ExploreEmbedded/ATmega32_ExploreStarterAvr/Others/Fritzing/Fritzing Tutorial Images/0_RTC_Starter_AVR_fritzing.png

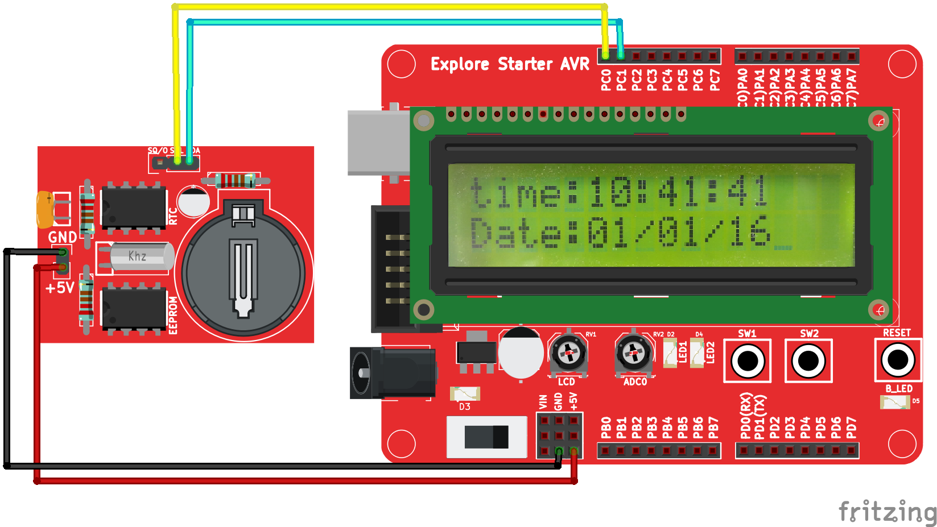
Others/Fritzing/Fritzing Tutorial Images/0_RTC_Starter_AVR_fritzing.png
