ExploreEmbedded/ATmega32_ExploreStarterAvr/Others/BOM/Explore Starter_AVR_BOM.xls

 | Explore Starter AVR |  | No. of PCB's | 25
Id | Designator | Package | Units | Designation | Qty. | Supplier and ref
1 | CON1 | USB B FEMALE SOLDER R/A | 1 | USB B Type | 25 | Namotronics
2 | SW4,SW3,SW1 | 2 pin through hole switch | 3 | 2 pin Tactile switch | 75 | Namotronics
3 | C7 | Electrolyte | 1 | 100uf/25V Capacitors | 25 | Namotronics
4 | K4,K3,K2 | 2.54mm Pitch through hole staright | 0.25 | Male Pin headers | 6.25 | Namotronics
5 | IC1 | DIP -40 | 1 | 40 Pin Low profile IC Socket | 25 | Namotronics
6 | J3,J2,J4,J5 | 2.54mm Pitch through hole staright | 1 | Male Pin headers | 25 | Namotronics
7 | P6 | 2.54mm Pitch through hole staright | 1 | 5X2 FRC Box headers | 25 | Namotronics
8 | RV1,RV2 | 3 pin Preset | 2 | 10K Potentiometer | 50 | Namotronics
10 | U1 | MLP-28 | 1 | CP2102 | 25 | Namotronics
11 | U2 | SOT223 | 1 | LM1117/5V | 25 | Namotronics
12 | X1 | Through hole | 1 | 16Mhz Crystal | 25 | Namotronics
13 | C10,C11,C1,C2,C3,C4,C5 | 1206 Package | 7 | 0.1uF Capacitors | 175 | Namotronics
15 | R1 | 1206 Package | 1 | 10K Resistors | 25 | Namotronics
17 | R3,R5,R6,R2 | 1206 Package | 4 | 470R Resistors | 100 | Namotronics
18 | R7,R8 | 1206 Package | 2 | 10k Resistors | 50 | Namotronics
19 | R9 | 1206 Package | 1 | 2.2k Resistors | 25 | Namotronics
20 | C8,C9 | 1206 Package | 2 | 22pF Capacitors | 50 | Namotronics
21 | D2,D3,D4,D5 | 1206 Package | 4 | Green LED | 100 | Namotronics
22 | K1 | DC Jack | 1 | BARREL_JACK | 25 | Namotronics
23 | LCD1 | 2.54mm Pitch through hole staright | 1 | Female Pin headers | 25 | Namotronics
24 | SW2 | 2.54mm 5 pin slide swith | 1 | R/A slide swith | 25 | Namotronics
