ExploreEmbedded/ATmega32_ExploreStarterAvr/Code/Tutorial Examples/LCD 16x2/LCD 16x2/New Microsoft Office Word Document.docx

#include <avr/io.h>

#include <util/delay.h>

#include "lcd.h"

/********************************************************************

26

27 Configuration Area.

28 UltraSonic (US) sensor connection.

29

30 in this example it is connected to PORTA bit 0

31

32 Adjust the following to connect is to different i/o

33

34 ********************************************************************/

#define US_PORT PORTA

#define US_PIN PINA

#define US_DDR DDRA

#define US_POS PA0 //PORTA0

#define trig PA1

/********************************************************************

44

45 This function measusers the width of high pulse in micro second.

46

47 ********************************************************************/

#define US_ERROR 0xffff

#define US_NO_OBSTACLE 0xfffe

uint16_t getPulseWidth()

{

uint32_t i,result;

//Wait for the rising edge

for(i=0;i<600000;i++)

{

if(!(US_PIN & (1<<US_POS))) continue; else break;

}

if(i==600000)

return 0xffff; //Indicates time out

//High Edge Found

//Setup Timer1

TCCR1A=0X00;

TCCR1B=(1<<CS11); //Prescaler = Fcpu/8

TCNT1=0x00; //Init counter

//Now wait for the falling edge

for(i=0;i<600000;i++)

{

if(US_PIN & (1<<US_POS))

{

if(TCNT1 > 60000) break; else continue;

}

else

break;

}

if(i==600000)

return 0xffff; //Indicates time out

//Falling edge found

result=TCNT1;

//Stop Timer

TCCR1B=0x00;

if(result > 60000)

return 0xfffe; //No obstacle

else

return (result>>1);

}

void Wait()

{

uint8_t i;

for(i=0;i<10;i++)

_delay_loop_2(0);

}

void main()

{

uint16_t r;

LCD_SetUp(PB_0,PB_1,PB_2,P_NC,P_NC,P_NC,P_NC,PC_4,PC_5,PC_6,PC_7);

LCD_Init(2,16);

LCD_DisplayString("Explore Embedded");

LCD_DisplayString("Lcd 4-bit Mode");

Wait();

while(1)

{

//Set Ultra Sonic Port as out

US_DDR|=(1<<trig);

_delay_us(10);

//Give the US pin a 15us High Pulse

US_PORT|=(1<<trig); //High

_delay_us(15);

US_PORT&=(~(1<<trig));//Low

_delay_us(20);

//Now make the pin input

US_DDR&=(~(1<<US_POS));

//Measure the width of pulse

r=getPulseWidth();

//Handle Errors

if(r==US_ERROR)

{

LCD_DisplayString("Error !");

}

else if(r==US_NO_OBSTACLE)

{

LCD_DisplayString("Clear !");

}

else

{

int d;

d = (r/58.0); //Convert to cm

LCD_Printf("%d",d);

// LCDWriteIntXY(0,0,d,4);

// LCDWriteString(" cm");

Wait();

}

}

}
