ExploreEmbedded/ATmega32_ExploreStarterAvr/Code/Tutorial Examples/Stepper/Stepper/code.docx

/*

* Stepper.c

*

* Created: 11-04-2016 13:04:41

* Author : Vaibhav

*/

#include <avr/io.h>

#include "delay.h"

#include "adc.h"

#define stepPin PB3

#define dirPin PB4

#define Enable PB5

int speedUp();

int customDelay,customDelayMapped;

int main(void)

{

ADC_Init();

/* Replace with your application code */

DDRB |= (1<<3)|(1<<4)|(1<<5);

PORTB |= (1<<4);

PORTB &= ~(1<<5);

int x;

while (1)

{

//volt = (adcValue*5.00)/1023;

customDelayMapped = speedUp();

// for(x=0; x<200; x++)

// {

PORTB |=(1<<3);

DELAY_us(customDelayMapped);

PORTB &=~(1<<3);

DELAY_us(customDelayMapped);

// }

//DELAY_ms(1000);

// PORTB &= ~(1<<4);

//for(x=0; x<400; x++)

//{

// PORTB |=(1<<3);

// DELAY_us(4000);

// PORTB &=~(1<<3);

// DELAY_us(4000);

//}

// DELAY_ms(1000);

}

}

// Function for reading the Potentiometer

int speedUp() {

int customDelay = ADC_GetAdcValue(0); // Reads the potentiometer

// int newCustom = map(customDelay, 0, 1023, 300,4000); // Convrests the read values of the potentiometer from 0 to 1023 into desireded delay values (300 to 4000)

return customDelay;

}
