ExploreEmbedded/ATmega32_ExploreStarterAvr/Others/Fritzing/Fritzing Tutorial Images/0_Stepper_Starter_AVR.png

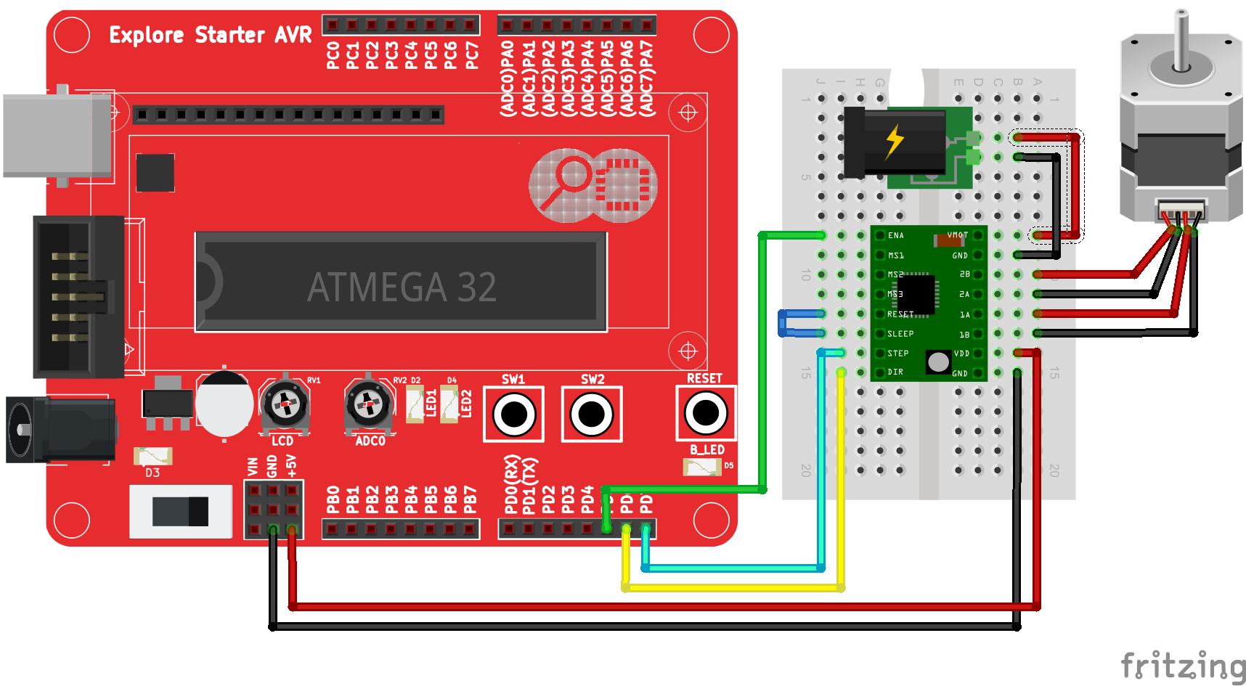
Others/Fritzing/Fritzing Tutorial Images/0_Stepper_Starter_AVR.png
