ExploreEmbedded/ATmega32_ExploreStarterAvr/Others/Fritzing/Fritzing Tutorial Images/7Segment_Starter_AVR1.png

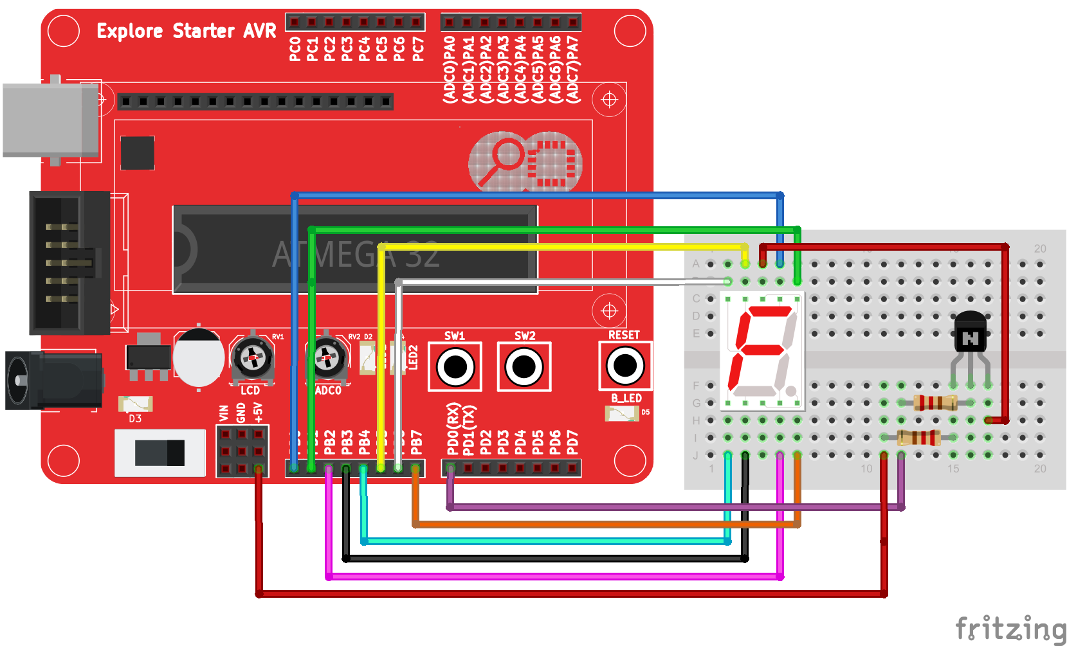
Others/Fritzing/Fritzing Tutorial Images/7Segment_Starter_AVR1.png
