ExploreEmbedded/ATmega32_ExploreStarterAvr/Others/Fritzing/Fritzing Tutorial Images/GLCD_Starter_AVR.png

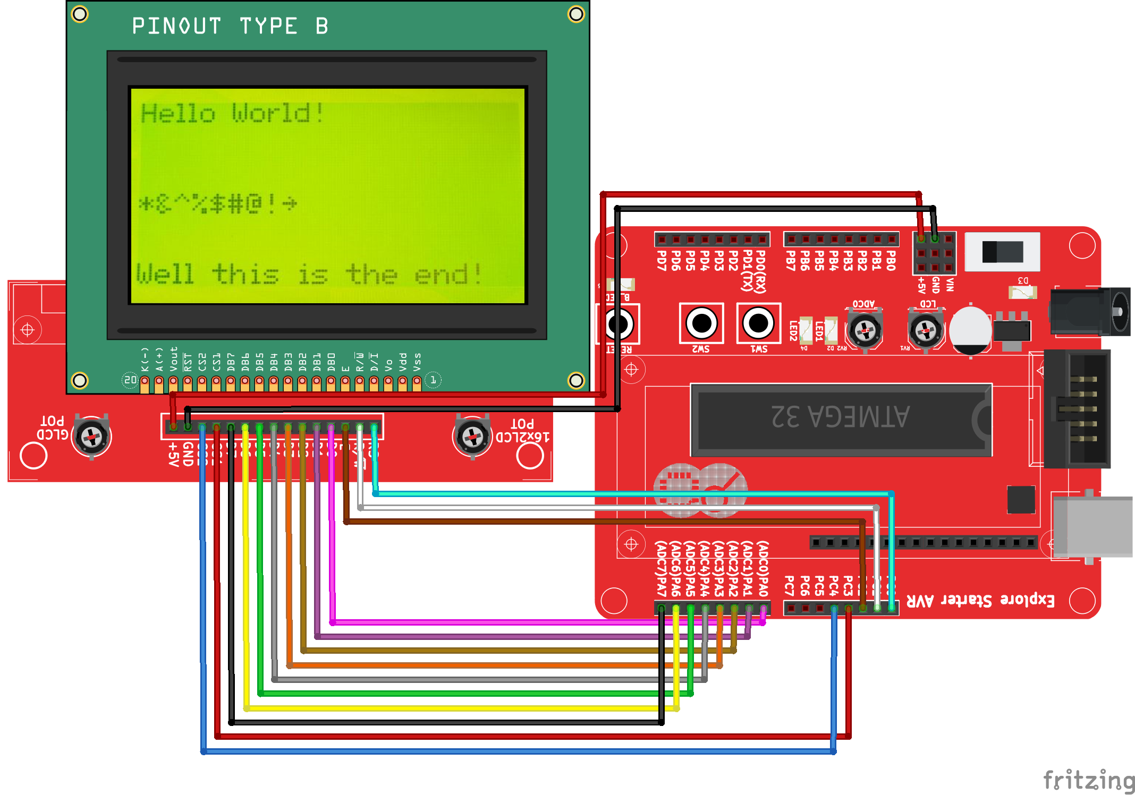
Others/Fritzing/Fritzing Tutorial Images/GLCD_Starter_AVR.png
