ExploreEmbedded/ATmega32_ExploreStarterAvr/Hardware/Starter_AVR.pdf

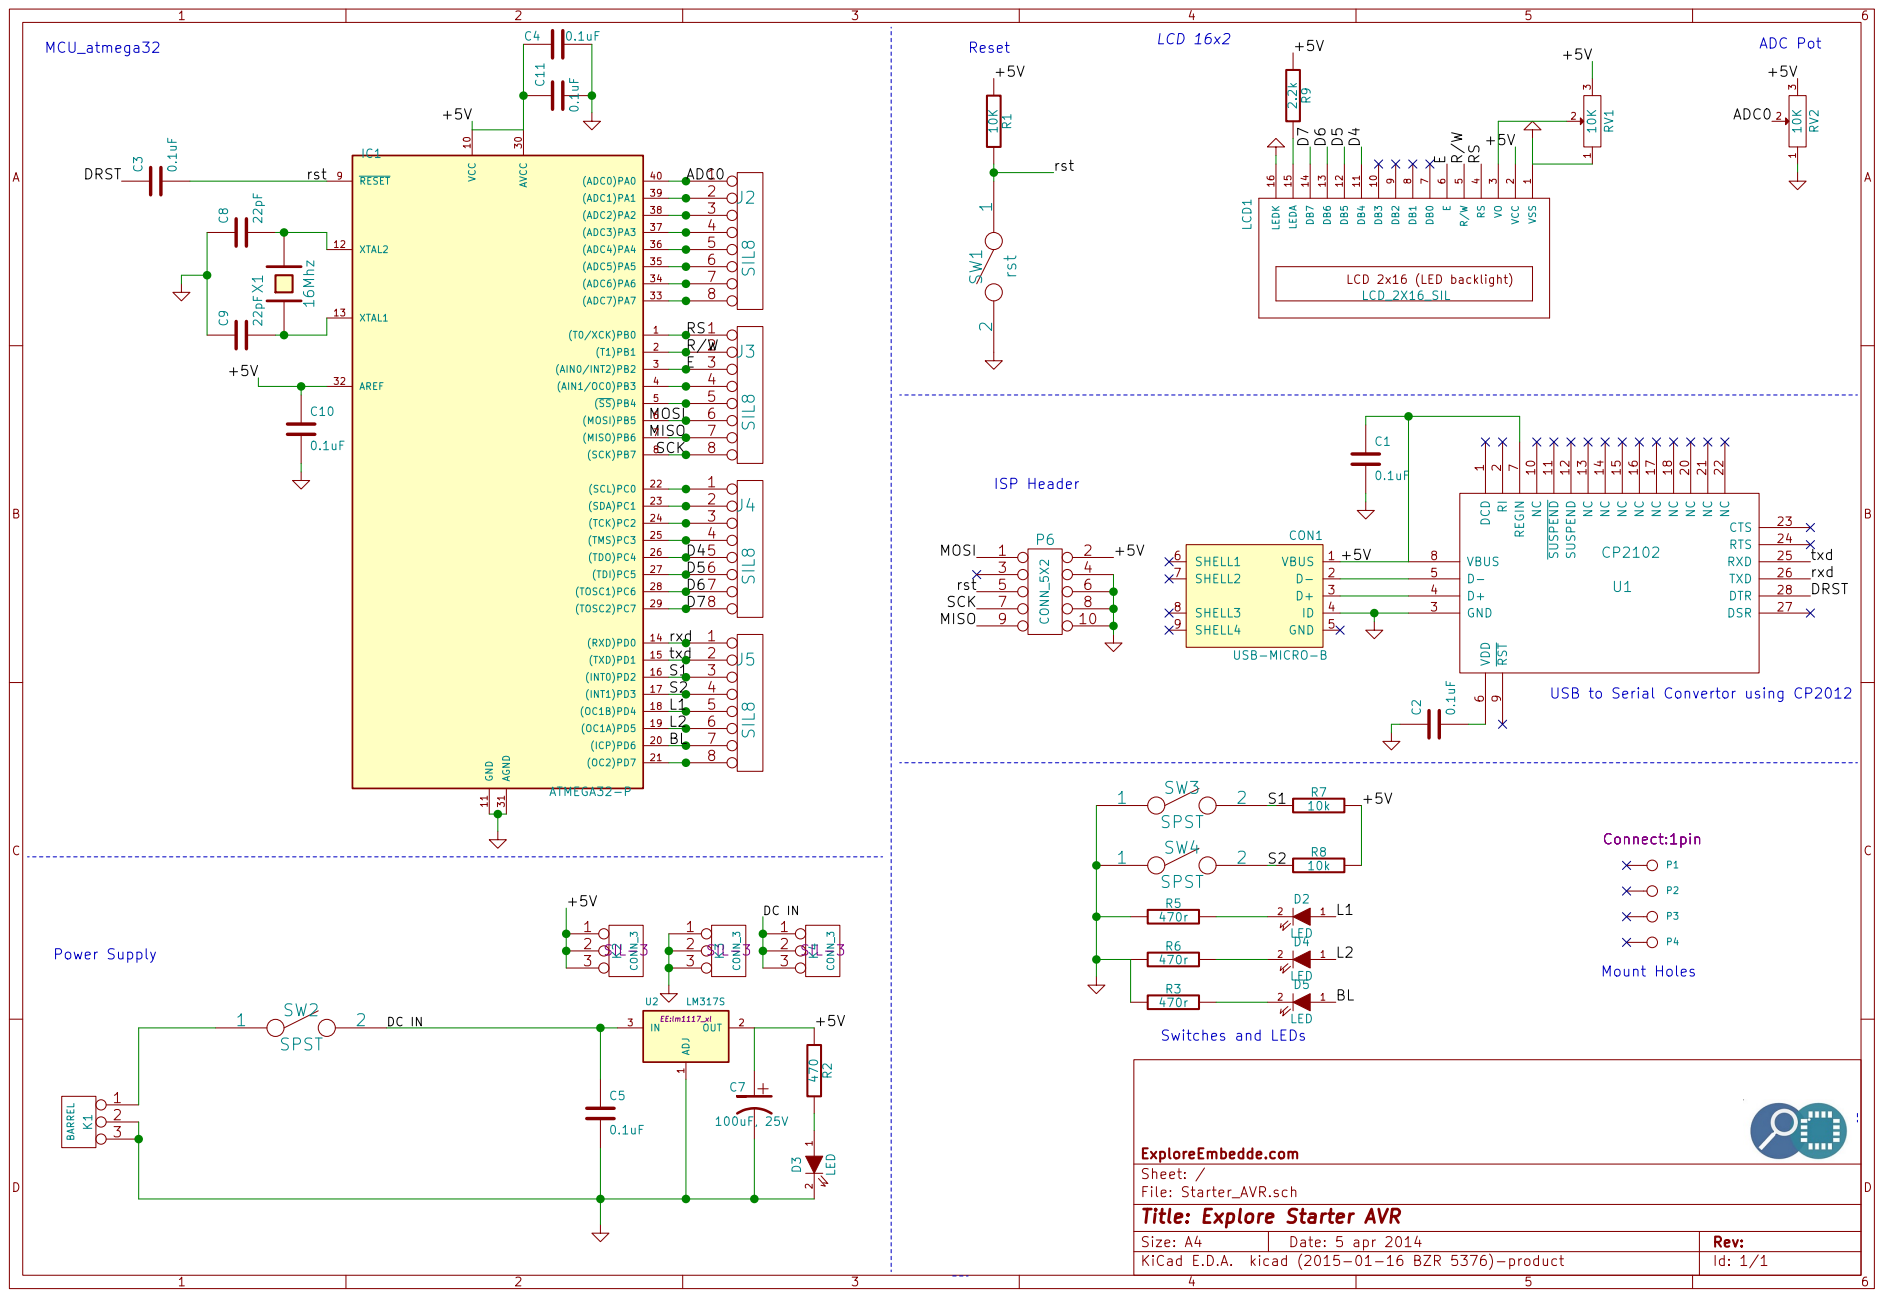
[picture p7: page 1]

9 NC 10 NC 20 SUSPEND 11 NC 21 SUSPEND 12 NC 22 NC 13 CTS 23 NC 14 RTS 24 NC 15 RXD 25 NC 16 TXD 26 NC 17 DSR 27 NC 18 DTR U1 28 CP2102 C1

File: Starter_AVR.sch Sheet: / ExploreEmbedde.com

Id: 1/1 Title: Explore Starter AVR
