ExploreEmbedded/ATmega32_ExploreStarterAvr/(list of files, drawings)

Other design files:
Others/Fritzing/Fritzing Tutorial Images/7segment.fzz
Others/Fritzing/Fritzing Tutorial Images/GLCD.fzz
Others/Fritzing/Fritzing Tutorial Images/LM35.fzz
Others/Fritzing/Fritzing Tutorial Images/RTC.fzz
Others/Fritzing/Fritzing Tutorial Images/Stepper.fzz
Others/Fritzing/Fritzing Tutorial Images/Ultrasonic.fzz
