ExploreEmbedded/ATmega32_ExploreStarterAvr/Hardware/Starter_AVR.kicad_pcb

## KiCad design Hardware/Starter_AVR.kicad_pcb (2016-03-23)

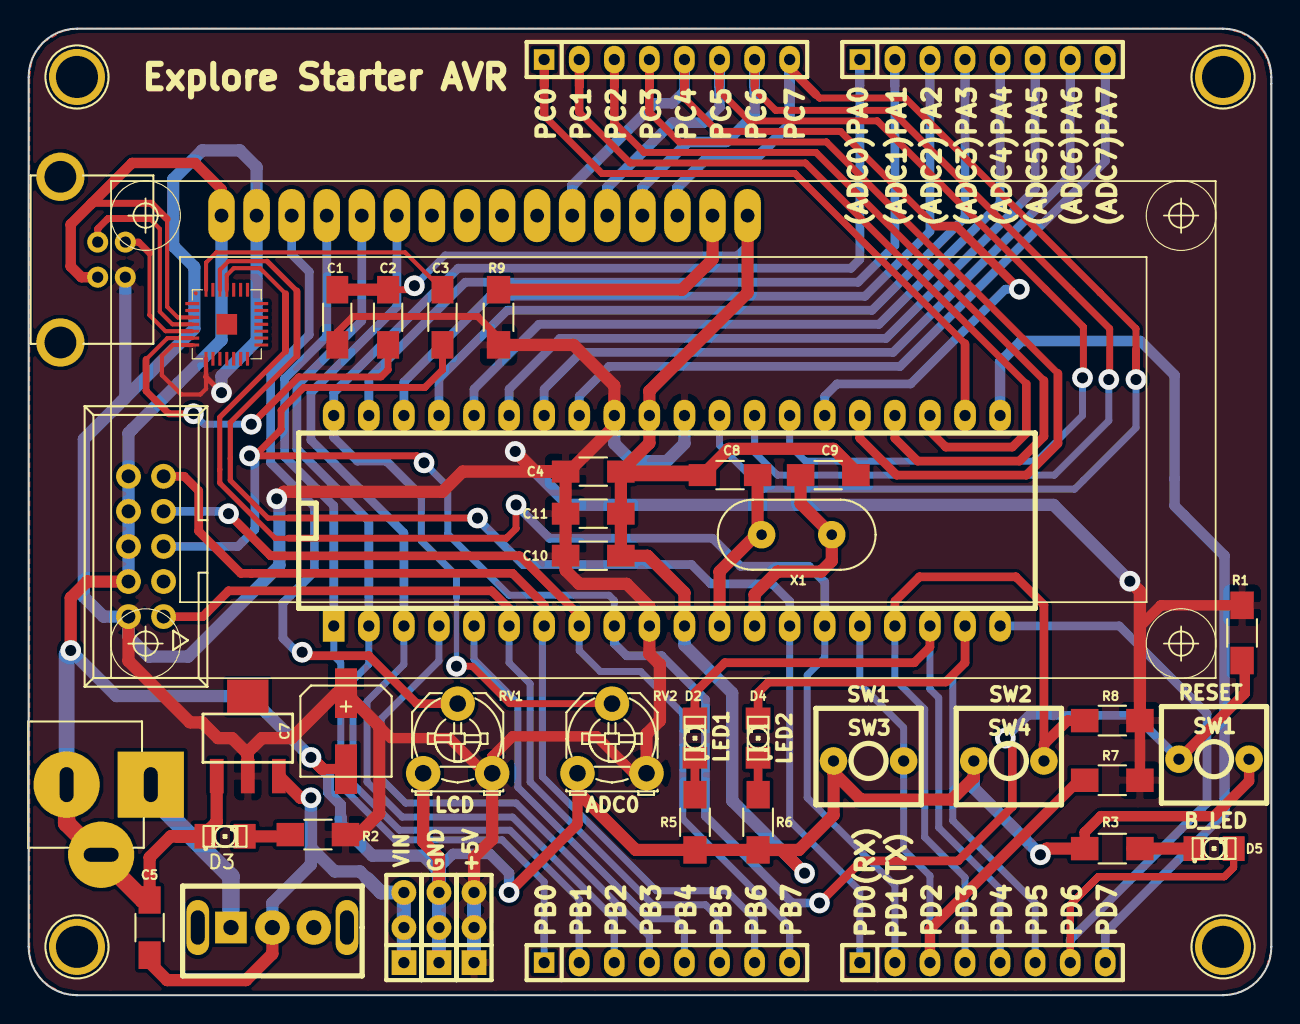
[picture p8: board Starter_AVR.kicad_pcb from above]

Board: 2 copper layers, 90.0 x 70.0 mm, 47 parts (0 on the bottom side), 49 nets.

Parts:
C1, C2, C3, C4, C5, C10, C11: 0.1uF; C_1206_HandSoldering
C7: 100uF, 25V; c_elec_6.3x4.5
C8, C9: 22pF; C_1206_HandSoldering
CON1: USB-MICRO-B; USB_B
D2, D3, D4, D5: LED; LED-1206_NEW
IC1: ATMEGA32-P; DIP-40__600_ELL
J2, J3, J4, J5: SIL8; SIL-8_xl
K1: BARREL; DC_Jack
K2, K3, K4: CONN_3; SIL-3
LCD1: LCD_2X16_SIL; lcd_2x16_led_backlight-HY-1602F
P1, P2, P3, P4: CONN_1; 1pin
P6: CONN_5X2; VASCH5x2
R1: 10K; R_1206_HandSoldering
R2: 470; R_1206_HandSoldering
R3, R5, R6: 470r; R_1206_HandSoldering
R7, R8: 10k; R_1206_HandSoldering
R9: 2.2k; R_1206_HandSoldering
RV1, RV2: 10K; Potentiometer_Triwood_RM-065
SW1: rst; SW_PUSH_SMALL_2pin_3D_xl
SW2: SPST; SlideSwitch_Big
SW3, SW4: SPST; SW_PUSH_SMALL_2pin_3D_xl
U1: CP2102; cp2102_xl2
U2: LM317S; lm1117_xl
X1: 16Mhz; HC-49V

Connections:
/+5V: C1.1, C4.1, C7.1, C10.1, C11.1, CON1.1, IC1.10, IC1.30, IC1.32, K2.1, K2.2, K2.3, LCD1.2, P6.2, R1.2, R2.2, R7.2, R8.2, R9.1, RV1.3, RV2.3, U1.7, U1.8, U2.2
/ADC0: IC1.40, J2.1, RV2.2
/BL: D5.1, IC1.20, J5.7
/D4: IC1.26, J4.5, LCD1.11
/D5: IC1.27, J4.6, LCD1.12
/D6: IC1.28, J4.7, LCD1.13
/D7: IC1.29, J4.8, LCD1.14
/DC IN: C5.1, K4.1, K4.2, K4.3, SW2.2, U2.3
/DRST: C3.1, U1.28
/E: IC1.3, J3.3, LCD1.6
/L1: D2.1, IC1.18, J5.5
/L2: D4.1, IC1.19, J5.6
/MISO: IC1.7, J3.7, P6.9
/MOSI: IC1.6, J3.6, P6.1
/R/W: IC1.2, J3.2, LCD1.5
/RS: IC1.1, J3.1, LCD1.4
/S1: IC1.16, J5.3, R7.1, SW3.2
/S2: IC1.17, J5.4, R8.1, SW4.2
/SCK: IC1.8, J3.8, P6.7
/rst: C3.2, IC1.9, P6.5, R1.1, SW1.1
/rxd: IC1.14, J5.1, U1.26
/txd: IC1.15, J5.2, U1.25
GND: C1.2, C2.1, C4.2, C5.2, C7.2, C8.1, C9.1, C10.2, C11.2, CON1.4, D3.2, IC1.11, IC1.31, K1.2, K1.3, K3.1, K3.2, K3.3, LCD1.1, LCD1.16, P6.4, P6.6, P6.8, P6.10, R3.1, R5.1, R6.1, RV1.1, RV2.1, SW1.2, SW3.1, SW4.1, U1.3, U2.1
unnamed: C2.2, U1.6
unnamed: C8.2, IC1.12, X1.2
unnamed: C9.2, IC1.13, X1.1
unnamed: CON1.2, U1.5
unnamed: CON1.3, U1.4
unnamed: D2.2, R5.2
unnamed: D3.1, R2.1
unnamed: D4.2, R6.2
unnamed: D5.2, R3.2
unnamed: IC1.4, J3.4
unnamed: IC1.5, J3.5
unnamed: IC1.21, J5.8
unnamed: IC1.22, J4.1
unnamed: IC1.23, J4.2
unnamed: IC1.24, J4.3
unnamed: IC1.25, J4.4
unnamed: IC1.33, J2.8
unnamed: IC1.34, J2.7
unnamed: IC1.35, J2.6
unnamed: IC1.36, J2.5
unnamed: IC1.37, J2.4
unnamed: IC1.38, J2.3
unnamed: IC1.39, J2.2
unnamed: K1.1, SW2.1
unnamed: LCD1.3, RV1.2
unnamed: LCD1.15, R9.2
