ExploreEmbedded/ATmega32_ExploreStarterAvr/(commit log)

2016-03-23 added design files
    [Starter_AVR.kicad_pcb, Starter_AVR.sch]
2016-03-23 Added files folder
    [Starter_AVR.kicad_pcb, Starter_AVR.sch]
2016-04-19 Starter_AVR_Complete
    Tutorials and code updated.
    [7segment.fzz, GLCD.fzz, LM35.fzz, RTC.fzz, Starter_AVR.kicad_pcb, Starter_AVR.sch, Stepper.fzz, Ultrasonic.fzz]
2016-12-08 Code and BOM updated
    [Explore Starter_AVR_BOM.xls]
2017-03-29 fixed ADC issue
    fixed ADC issue for atmega32
    [main.c]
